ramonimbao/arisu-pcb/PlateLayer_Centered.dxf

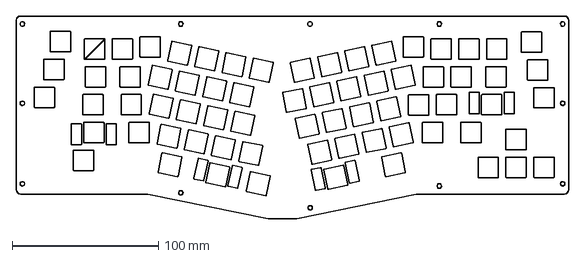
[picture p1: CAD file, 2021-05-03]
PlateLayer_Centered.dxf
378.3 x 138.8 mm
