ramonimbao/arisu-pcb/PlateLayer.dxf

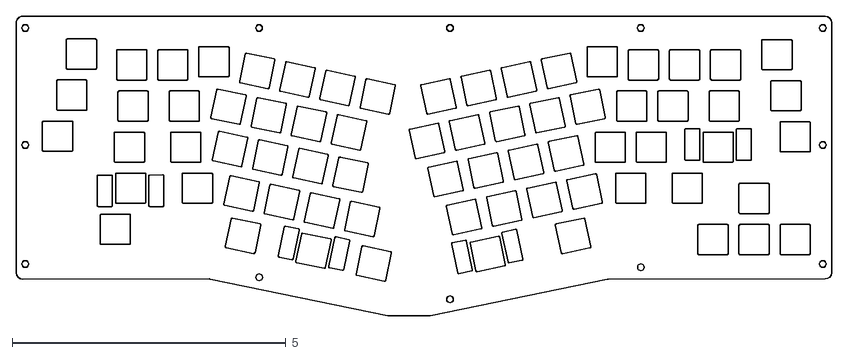
[picture p2: CAD file, 2021-05-03]
PlateLayer.dxf
14.9 x 5.47
