ramonimbao/arisu-pcb/arisu.kicad_pcb

## KiCad design arisu.kicad_pcb (2021-05-03)

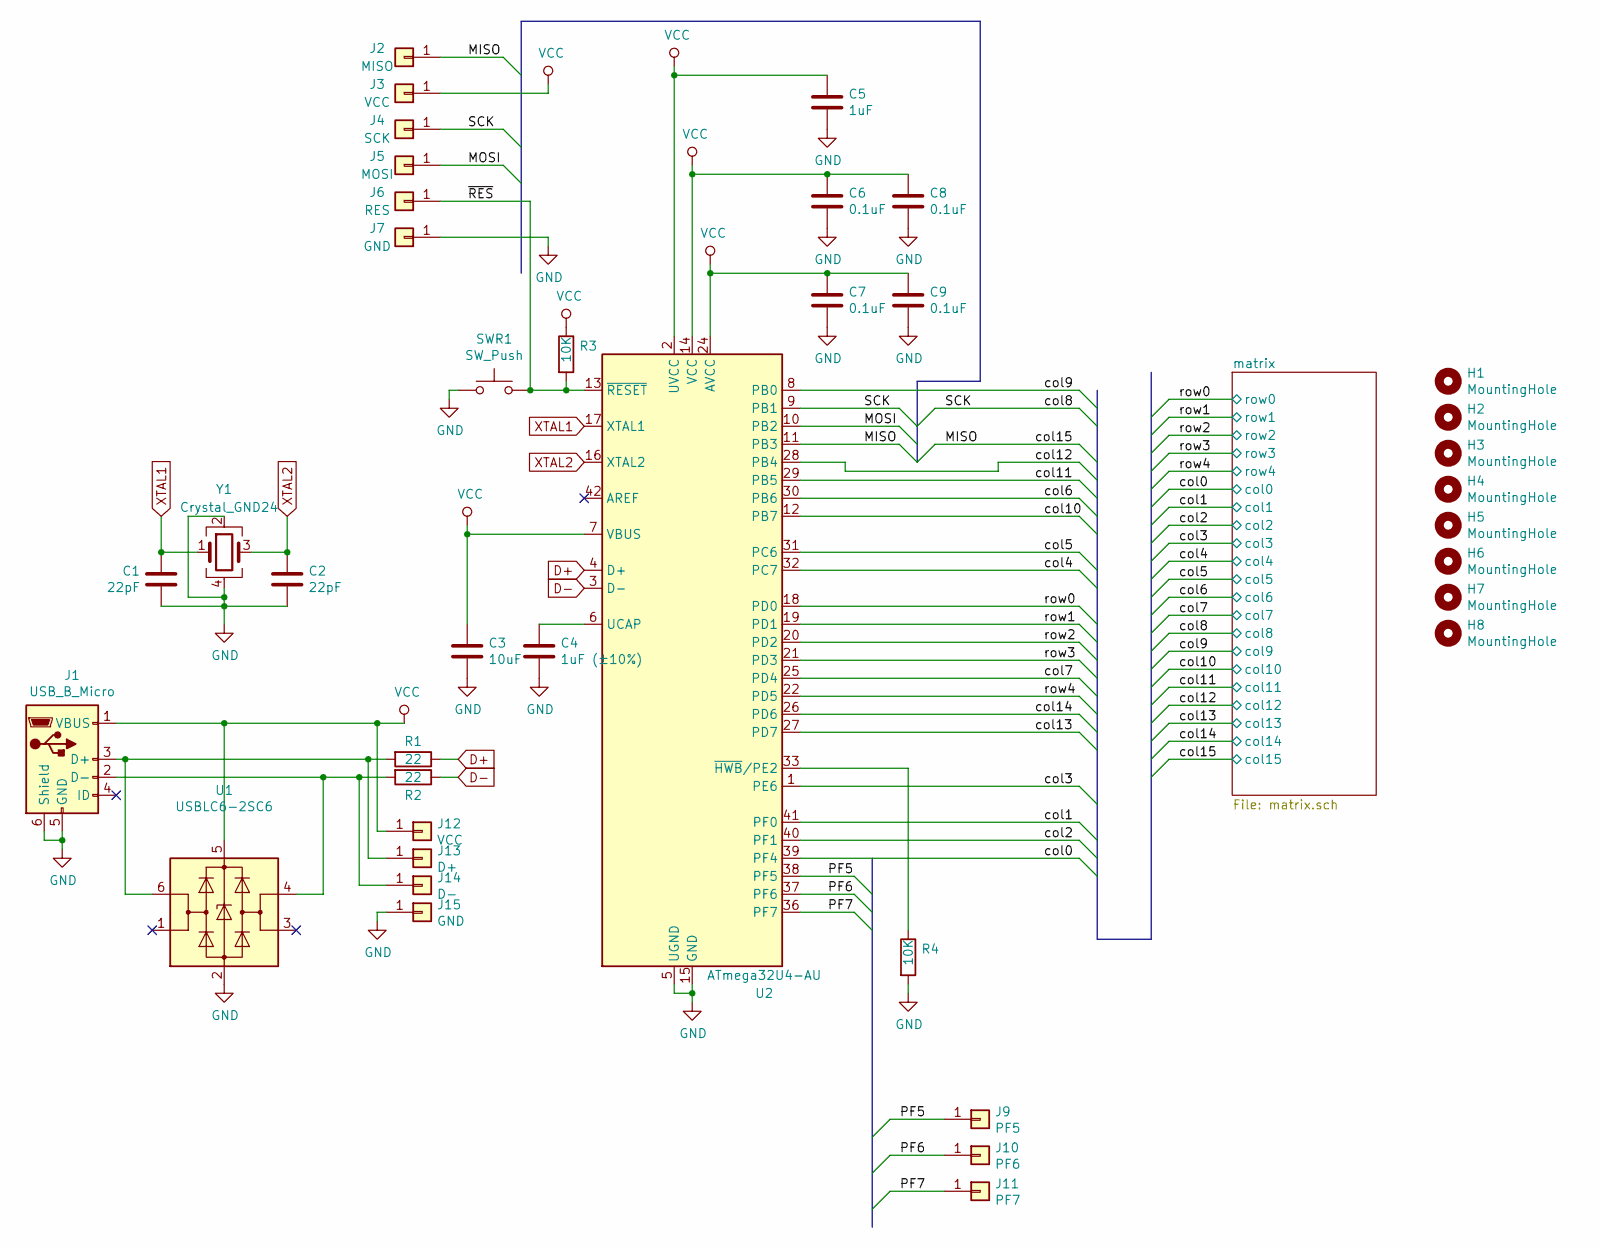
[picture p3: schematic arisu.sch]

Parts:
C1, C2: 22pF; C_0805_HandSoldering
C3: 10uF; C_0805_HandSoldering
C4: 1uF (±10%); C_0805_HandSoldering
C5: 1uF; C_0805_HandSoldering
C6, C7, C8, C9: 0.1uF; C_0805_HandSoldering
H1, H2, H3, H4, H5, H6, H7, H8: MountingHole; MountingHole_2.2mm_M2_Pad
J1: USB_B_Micro; USB_Micro-B_Molex-105017-0001
J2: MISO; Pin_Header_Straight_1x01_Pitch2.54mm
J3, J12: VCC; Pin_Header_Straight_1x01_Pitch2.54mm
J4: SCK; Pin_Header_Straight_1x01_Pitch2.54mm
J5: MOSI; Pin_Header_Straight_1x01_Pitch2.54mm
J6: RES; Pin_Header_Straight_1x01_Pitch2.54mm
J7, J15: GND; Pin_Header_Straight_1x01_Pitch2.54mm
J9: PF5; Pin_Header_Straight_1x01_Pitch2.54mm
J10: PF6; Pin_Header_Straight_1x01_Pitch2.54mm
J11: PF7; Pin_Header_Straight_1x01_Pitch2.54mm
J13: D+; Pin_Header_Straight_1x01_Pitch2.54mm
J14: D-; Pin_Header_Straight_1x01_Pitch2.54mm
R1, R2: 22; R_0805_HandSoldering
R3, R4: 10K; R_0805_HandSoldering
SWR1: SW_Push; SW_SPST_TL3342
U1: USBLC6-2SC6; SOT-23-6_Handsoldering
U2: ATmega32U4-AU; TQFP-44_10x10mm_Pitch0.8mm
Y1: Crystal_GND24; Crystal_SMD_SeikoEpson_FA238-4pin_3.2x2.5mm_HandSoldering

Connections:
/MISO: J2.1, U2.11 (PB3); also elsewhere on the board
/MOSI: J5.1, U2.10 (PB2)
/PF5: J9.1, U2.38 (PF5)
/PF6: J10.1, U2.37 (PF6)
/PF7: J11.1, U2.36 (PF7)
/SCK: J4.1, U2.9 (PB1); also elsewhere on the board
/col0: U2.39 (PF4); also elsewhere on the board
/col1: U2.41 (PF0); also elsewhere on the board
/col2: U2.40 (PF1); also elsewhere on the board
/col3: U2.1 (PE6); also elsewhere on the board
/col4: U2.32 (PC7); also elsewhere on the board
/col5: U2.31 (PC6); also elsewhere on the board
/col6: U2.30 (PB6); also elsewhere on the board
/col7: U2.25 (PD4); also elsewhere on the board
/col9: U2.8 (PB0); also elsewhere on the board
/col10: U2.12 (PB7); also elsewhere on the board
/col11: U2.29 (PB5); also elsewhere on the board
/col12: U2.28 (PB4); also elsewhere on the board
/col13: U2.27 (PD7); also elsewhere on the board
/col14: U2.26 (PD6); also elsewhere on the board
/row0: U2.18 (PD0); also elsewhere on the board
/row1: U2.19 (PD1); also elsewhere on the board
/row2: U2.20 (PD2); also elsewhere on the board
/row3: U2.21 (PD3); also elsewhere on the board
/row4: U2.22 (PD5); also elsewhere on the board
/~RES~: J6.1, R3.2, SWR1.2, U2.13 (~RESET)
D+: R1.1, U2.4 (D+)
D-: R2.1, U2.3 (D-)
GND: C1.1, C2.2, C3.2, C4.2, C5.2, C6.2, C7.2, C8.2, C9.2, J1.5 (GND), J1.6 (Shield), J7.1, J15.1, R4.2, SWR1.1, U1.2 (GND), U2.5 (UGND), U2.15 (GND), U2.23 (GND), U2.35 (GND), U2.43 (GND), Y1.2, Y1.4
unnamed: C4.1, U2.6 (UCAP)
unnamed: J1.2 (D-), J14.1, R2.2, U1.4 (I/O2)
unnamed: J1.3 (D+), J13.1, R1.2, U1.6 (I/O1)
unnamed: R4.1, U2.33 (~HWB~/PE2)
VCC: C3.1, C5.1, C6.1, C7.1, C8.1, C9.1, J1.1 (VBUS), J3.1, J12.1, R3.1, U1.5 (VBUS), U2.2 (UVCC), U2.7 (VBUS), U2.14 (VCC), U2.24 (AVCC), U2.34 (VCC), U2.44 (AVCC)
XTAL1: C1.2, U2.17 (XTAL1), Y1.1
XTAL2: C2.1, U2.16 (XTAL2), Y1.3

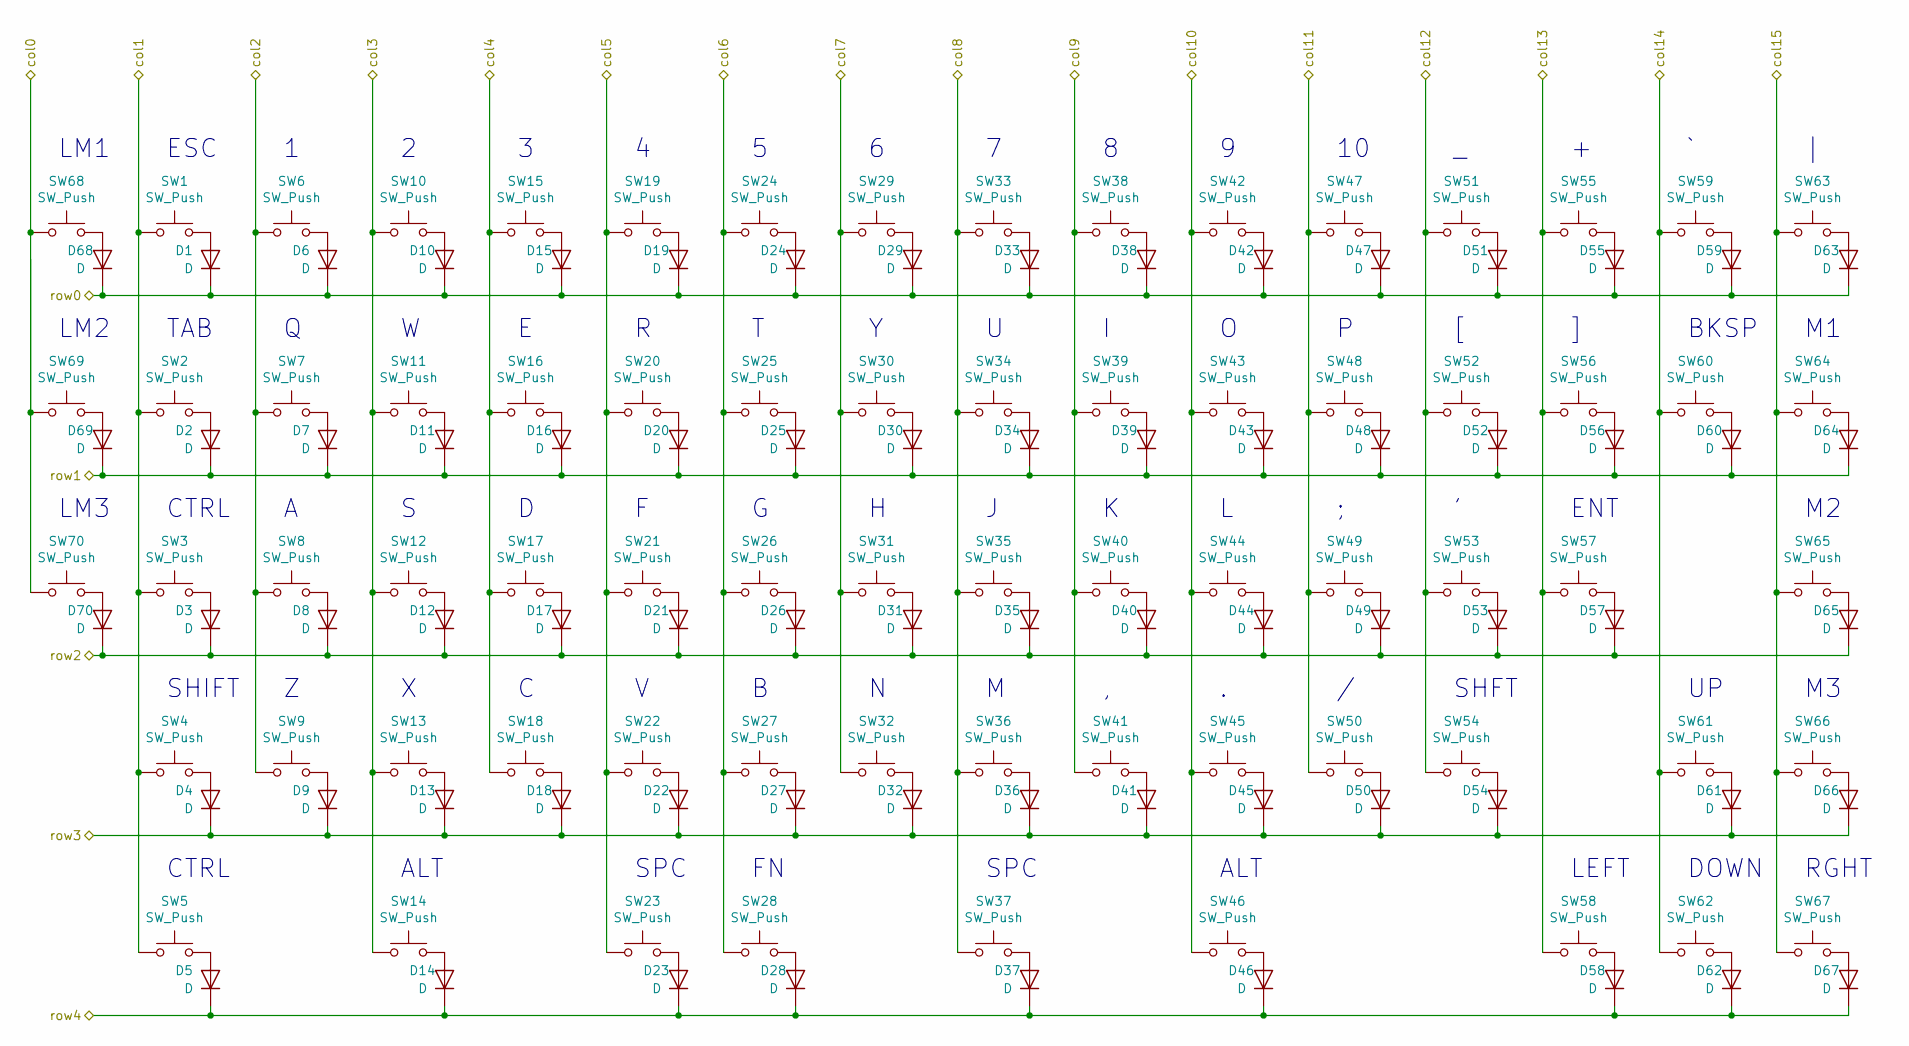
[picture p4: schematic matrix.sch]

Parts:
D1, D2, D3, D4, D5, D6, D7, D8, D9, D10, D11, D12, D13, D14, D15, D16, D17, D18, D19, D20, D21, D22, D23, D24, D25, D26, D27, D28, D29, D30, D31, D32, D33, D34, D35, D36, D37, D38, D39, D40, D41, D42, D43, D44, D45, D46, D47, D48, D49, D50, D51, D52, D53, D54, D55, D56, D57, D58, D59, D60, D61, D62, D63, D64, D65, D66, D67, D68, D69, D70: D; D_SOD-123
SW1, SW6, SW7, SW8, SW9, SW10, SW11, SW12, SW13, SW15, SW16, SW17, SW18, SW19, SW20, SW21, SW22, SW24, SW25, SW26, SW27, SW28, SW29, SW30, SW31, SW32, SW33, SW34, SW35, SW36, SW38, SW39, SW40, SW41, SW42, SW43, SW44, SW45, SW47, SW48, SW49, SW50, SW51, SW52, SW53, SW55, SW56, SW58, SW59, SW61, SW62, SW63, SW64, SW65, SW66, SW67, SW68, SW69, SW70: SW_Push; SW_Cherry_MX_1.00u_PCB
SW2, SW5, SW14, SW46, SW60: SW_Push; SW_Cherry_MX_1.50u_PCB
SW3, SW54: SW_Push; SW_Cherry_MX_1.75u_PCB
SW4: SW_Push; SW_Cherry_MX_2.25u_PCB
SW23: SW_Push; SW_Cherry_MX_2.00u_PCB_ReversedStabilizers
SW37: SW_Push; SW_Cherry_MX_2.75u_PCB_ReversedStabilizers
SW57: SW_Push; SW_Cherry_MX_2.25u_PCB_ReversedStabilizers

Connections:
/MISO: SW63.1, SW64.1, SW65.1, SW66.1, SW67.1; also elsewhere on the board
/SCK: SW33.1, SW34.1, SW35.1, SW36.1, SW37.1; also elsewhere on the board
/col0: SW68.1, SW69.1, SW70.1; also elsewhere on the board
/col1: SW1.1, SW2.1, SW3.1, SW4.1, SW5.1; also elsewhere on the board
/col2: SW6.1, SW7.1, SW8.1, SW9.1; also elsewhere on the board
/col3: SW10.1, SW11.1, SW12.1, SW13.1, SW14.1; also elsewhere on the board
/col4: SW15.1, SW16.1, SW17.1, SW18.1; also elsewhere on the board
/col5: SW19.1, SW20.1, SW21.1, SW22.1, SW23.1; also elsewhere on the board
/col6: SW24.1, SW25.1, SW26.1, SW27.1, SW28.1; also elsewhere on the board
/col7: SW29.1, SW30.1, SW31.1, SW32.1; also elsewhere on the board
/col9: SW38.1, SW39.1, SW40.1, SW41.1; also elsewhere on the board
/col10: SW42.1, SW43.1, SW44.1, SW45.1, SW46.1; also elsewhere on the board
/col11: SW47.1, SW48.1, SW49.1, SW50.1; also elsewhere on the board
/col12: SW51.1, SW52.1, SW53.1, SW54.1; also elsewhere on the board
/col13: SW55.1, SW56.1, SW57.1, SW58.1; also elsewhere on the board
/col14: SW59.1, SW60.1, SW61.1, SW62.1; also elsewhere on the board
/row0: D1.1 (K), D6.1 (K), D10.1 (K), D15.1 (K), D19.1 (K), D24.1 (K), D29.1 (K), D33.1 (K), D38.1 (K), D42.1 (K), D47.1 (K), D51.1 (K), D55.1 (K), D59.1 (K), D63.1 (K), D68.1 (K); also elsewhere on the board
/row1: D2.1 (K), D7.1 (K), D11.1 (K), D16.1 (K), D20.1 (K), D25.1 (K), D30.1 (K), D34.1 (K), D39.1 (K), D43.1 (K), D48.1 (K), D52.1 (K), D56.1 (K), D60.1 (K), D64.1 (K), D69.1 (K); also elsewhere on the board
/row2: D3.1 (K), D8.1 (K), D12.1 (K), D17.1 (K), D21.1 (K), D26.1 (K), D31.1 (K), D35.1 (K), D40.1 (K), D44.1 (K), D49.1 (K), D53.1 (K), D57.1 (K), D65.1 (K), D70.1 (K); also elsewhere on the board
/row3: D4.1 (K), D9.1 (K), D13.1 (K), D18.1 (K), D22.1 (K), D27.1 (K), D32.1 (K), D36.1 (K), D41.1 (K), D45.1 (K), D50.1 (K), D54.1 (K), D61.1 (K), D66.1 (K); also elsewhere on the board
/row4: D5.1 (K), D14.1 (K), D23.1 (K), D28.1 (K), D37.1 (K), D46.1 (K), D58.1 (K), D62.1 (K), D67.1 (K); also elsewhere on the board
unnamed: D1.2 (A), SW1.2
unnamed: D2.2 (A), SW2.2
unnamed: D3.2 (A), SW3.2
unnamed: D4.2 (A), SW4.2
unnamed: D5.2 (A), SW5.2
unnamed: D6.2 (A), SW6.2
unnamed: D7.2 (A), SW7.2
unnamed: D8.2 (A), SW8.2
unnamed: D9.2 (A), SW9.2
unnamed: D10.2 (A), SW10.2
unnamed: D11.2 (A), SW11.2
unnamed: D12.2 (A), SW12.2
unnamed: D13.2 (A), SW13.2
unnamed: D14.2 (A), SW14.2
unnamed: D15.2 (A), SW15.2
unnamed: D16.2 (A), SW16.2
unnamed: D17.2 (A), SW17.2
unnamed: D18.2 (A), SW18.2
unnamed: D19.2 (A), SW19.2
unnamed: D20.2 (A), SW20.2
unnamed: D21.2 (A), SW21.2
unnamed: D22.2 (A), SW22.2
unnamed: D23.2 (A), SW23.2
unnamed: D24.2 (A), SW24.2
unnamed: D25.2 (A), SW25.2
unnamed: D26.2 (A), SW26.2
unnamed: D27.2 (A), SW27.2
unnamed: D28.2 (A), SW28.2
unnamed: D29.2 (A), SW29.2
unnamed: D30.2 (A), SW30.2
unnamed: D31.2 (A), SW31.2
unnamed: D32.2 (A), SW32.2
unnamed: D33.2 (A), SW33.2
unnamed: D34.2 (A), SW34.2
unnamed: D35.2 (A), SW35.2
unnamed: D36.2 (A), SW36.2
unnamed: D37.2 (A), SW37.2
unnamed: D38.2 (A), SW38.2
unnamed: D39.2 (A), SW39.2
unnamed: D40.2 (A), SW40.2
unnamed: D41.2 (A), SW41.2
unnamed: D42.2 (A), SW42.2
unnamed: D43.2 (A), SW43.2
unnamed: D44.2 (A), SW44.2
unnamed: D45.2 (A), SW45.2
unnamed: D46.2 (A), SW46.2
unnamed: D47.2 (A), SW47.2
unnamed: D48.2 (A), SW48.2
unnamed: D49.2 (A), SW49.2
unnamed: D50.2 (A), SW50.2
unnamed: D51.2 (A), SW51.2
unnamed: D52.2 (A), SW52.2
unnamed: D53.2 (A), SW53.2
unnamed: D54.2 (A), SW54.2
unnamed: D55.2 (A), SW55.2
unnamed: D56.2 (A), SW56.2
unnamed: D57.2 (A), SW57.2
unnamed: D58.2 (A), SW58.2
unnamed: D59.2 (A), SW59.2
unnamed: D60.2 (A), SW60.2
unnamed: D61.2 (A), SW61.2
unnamed: D62.2 (A), SW62.2
unnamed: D63.2 (A), SW63.2
unnamed: D64.2 (A), SW64.2
unnamed: D65.2 (A), SW65.2
unnamed: D66.2 (A), SW66.2
unnamed: D67.2 (A), SW67.2
unnamed: D68.2 (A), SW68.2
unnamed: D69.2 (A), SW69.2
unnamed: D70.2 (A), SW70.2

Notes on the sheet:
ESC
TAB
BKSP
CTRL
ENT
SHIFT
SHFT
ALT
SPC
DOWN
LEFT
RGHT
LM1
LM2
LM3

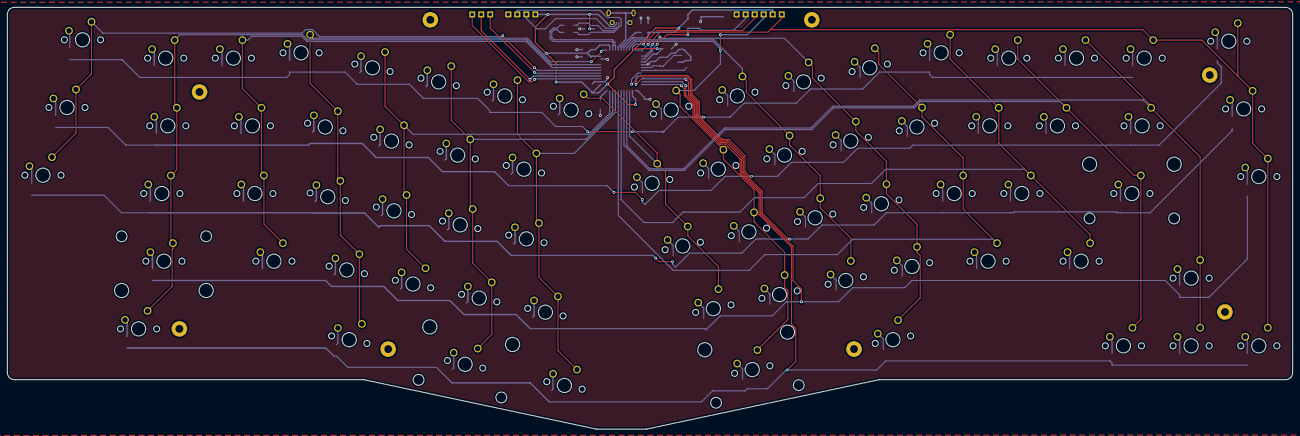
[picture p5: board arisu.kicad_pcb from above]

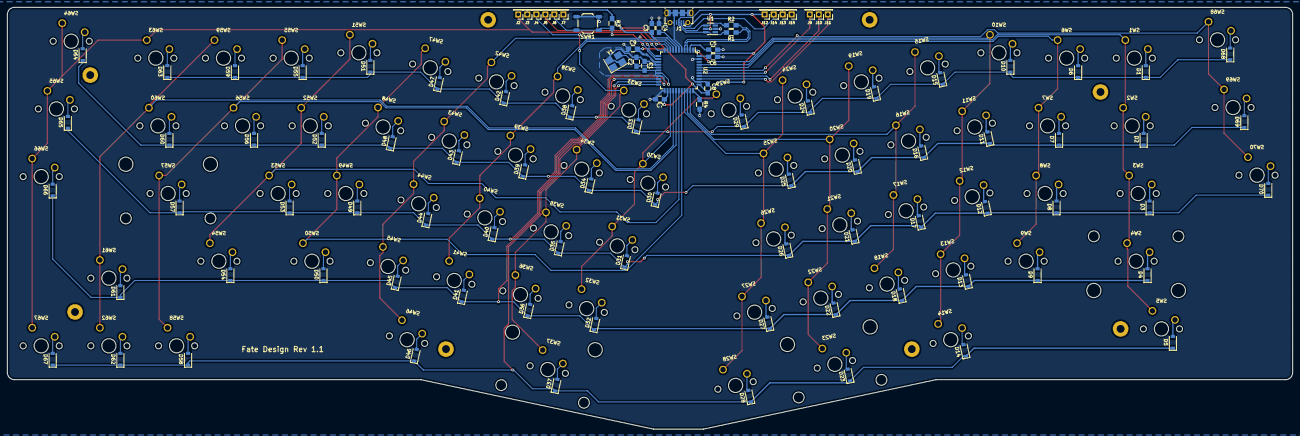
[picture p6: board arisu.kicad_pcb from below]

Board: 2 copper layers, 361.7 x 118.7 mm, 179 parts (101 on the bottom side), 106 nets.
