ramonimbao/arisu-pcb/(commit log)

2021-05-03 Modify arisu PCB for oncelot#1574
    [PlateLayer.dxf, PlateLayer_Centered.dxf]
2021-05-03 Finalize sch and pcb
    [arisu.kicad_pcb, arisu.sch, matrix.sch]
2021-05-03 Generate gerbers and add BOM/CPL files for JLCPCB
    [arisu-B_Cu.gbl, arisu-B_Mask.gbs, arisu-B_SilkS.gbo, arisu-Edge_Cuts.gm1, arisu-F_Cu.gtl, arisu-F_Mask.gts, arisu-F_SilkS.gto, arisu-NPTH.drl]
2021-05-03 Change .gitignore
    [arisu_BOM.csv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]
